meirmmk/fpga-oscilloscope/docs/waveforms/adc_out_to_vga_shell_waveform.png

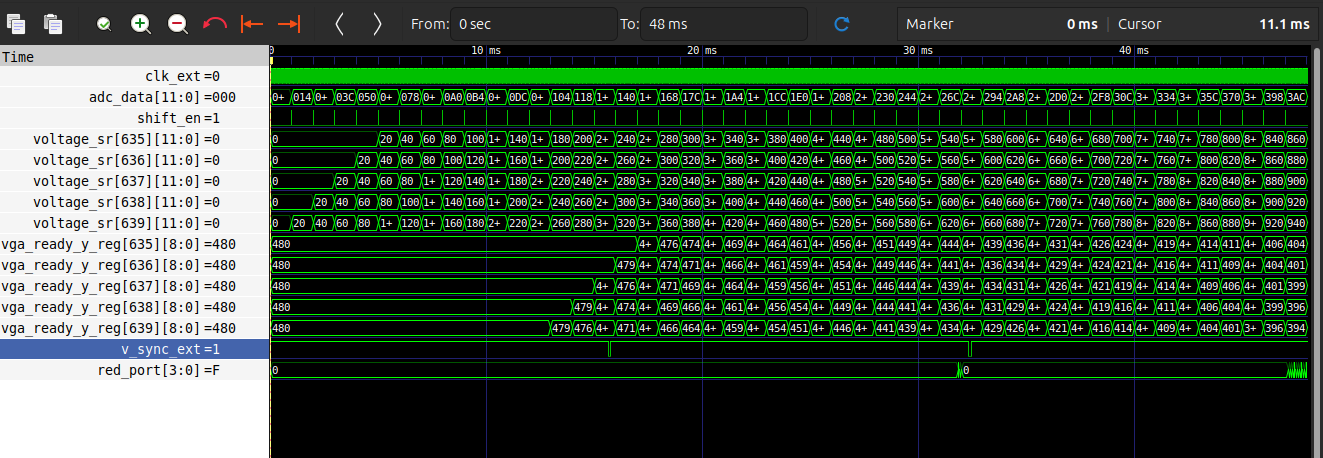
docs/waveforms/adc_out_to_vga_shell_waveform.png
