meirmmk/fpga-oscilloscope/docs/waveforms/vga_sync_H.png

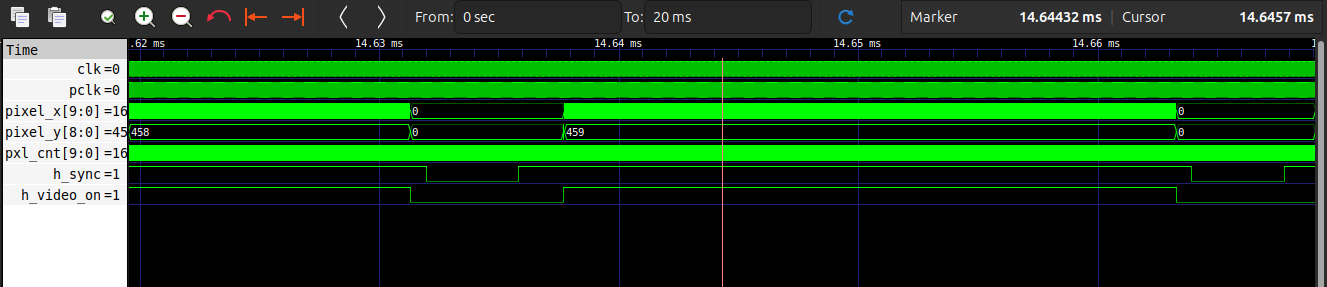
docs/waveforms/vga_sync_H.png
