meirmmk/fpga-oscilloscope/docs/waveforms/vga_sync_H_annotated.png

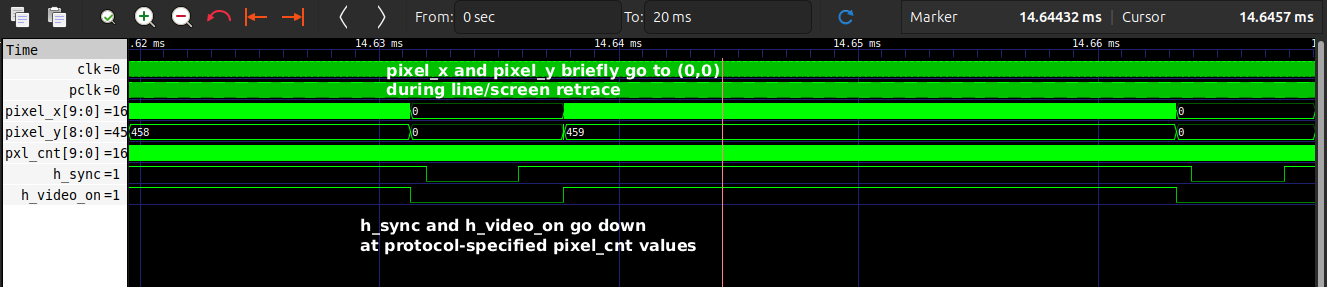
docs/waveforms/vga_sync_H_annotated.png
