meirmmk/fpga-oscilloscope/docs/waveforms/vga_sync_V.png

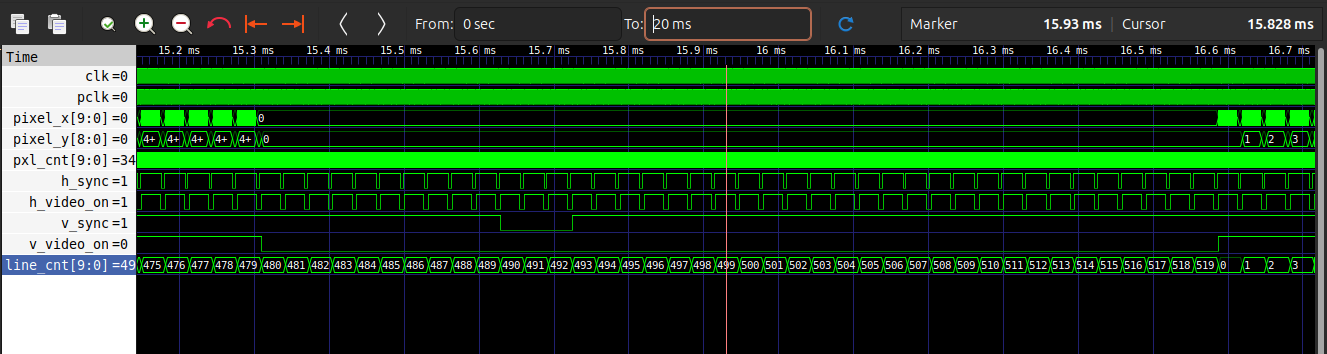
docs/waveforms/vga_sync_V.png
