meirmmk/fpga-oscilloscope/(commit log)

2026-07-07 Include LTspice schematic in README
    Added LTspice schematic image for the analog front-end.
2026-07-08 Fixing the metastability issue
    [cs_rising_edge.vhd]
